Luka-Zagar/crash-detection/[02] PROBE 3D MODEL/[04] FULL ASSEMBLY v11.step

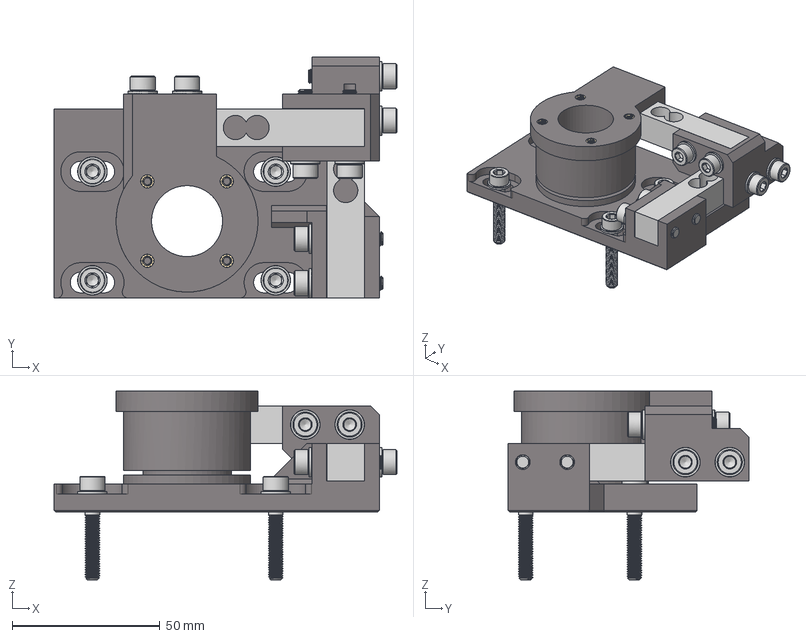
[picture p4: CAD file, 2026-10-09]
[02] PROBE 3D MODEL/[04] FULL ASSEMBLY v11.step
116.0 x 81.5 x 63.9 mm
DAVI - BASE PLATE
LOAD CELL x 2
91166A545_Zinc-Plated Steel General Purpose Washer x 12
91292A192_18-8 Stainless Steel Socket Head Screw x 4
95263A402_Alloy Steel Socket Head Screw x 8
94459A140_Heat-Set Inserts for Plastic x 4
LOAD CELL - BASE PLATE
LASER - BASE TUBE
