Luka-Zagar/crash-detection/[03] CASE 3D MODEL/[04] FULL ASSEMBLY v7.step

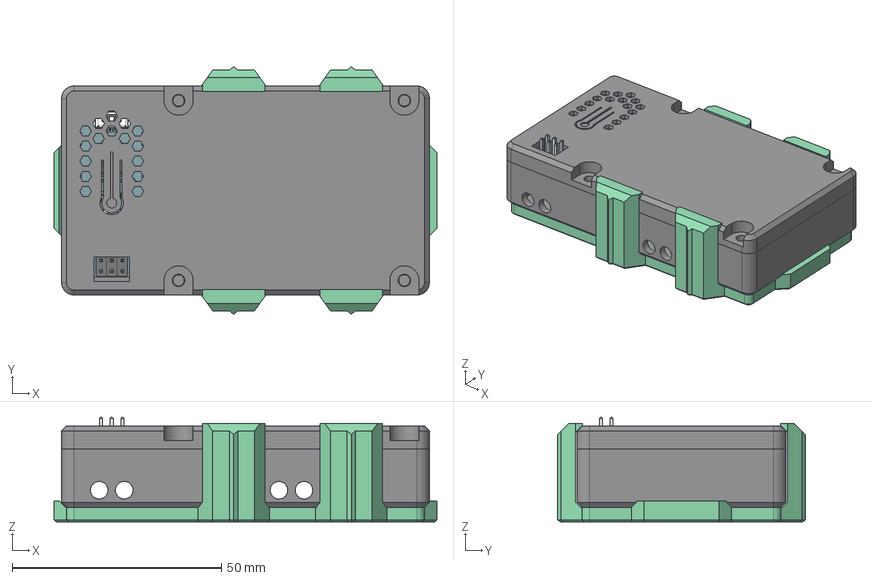
[picture p5: CAD file, 2026-10-09]
[03] CASE 3D MODEL/[04] FULL ASSEMBLY v7.step
91.6 x 59.2 x 25.1 mm
ADS1256 ENCLOSURE BOTTOM
ADS1256 ENCLOSURE TOP
Arduino Nano R3 modified
CLIP PLATE
