Luka-Zagar/crash-detection/[02] PROBE 3D MODEL/[01] DAVI BASE PLATE.step

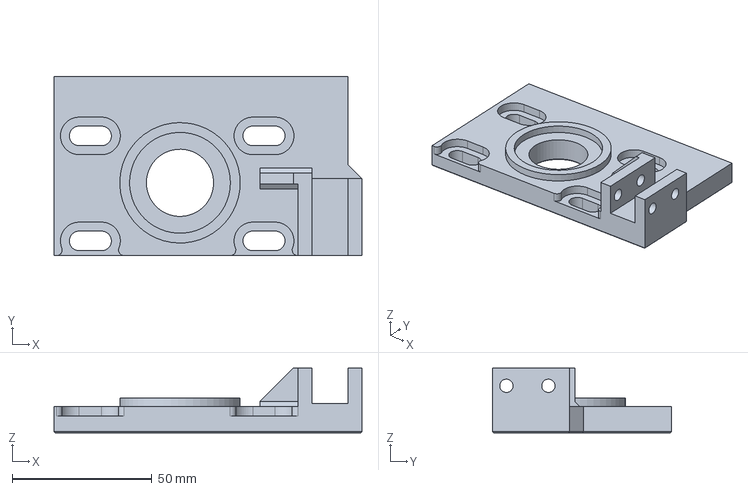
[picture p6: CAD file, 2026-10-09]
[02] PROBE 3D MODEL/[01] DAVI BASE PLATE.step
110.0 x 64.0 x 23.2 mm
