Luka-Zagar/crash-detection/[03] CASE 3D MODEL/[03] CLIP PLATE.step

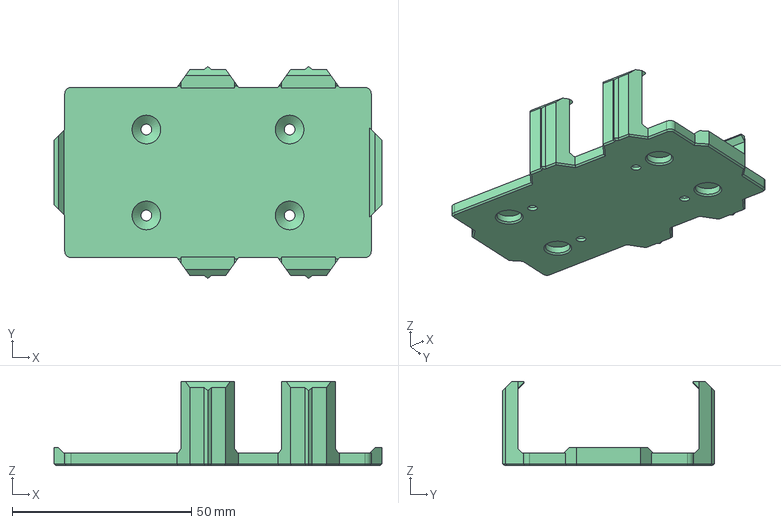
[picture p7: CAD file, 2026-10-09]
[03] CASE 3D MODEL/[03] CLIP PLATE.step
91.6 x 59.2 x 23.5 mm
