Luka-Zagar/crash-detection/[04] 3D PRINTED FILES/CASE PRINTED FILES.3mf

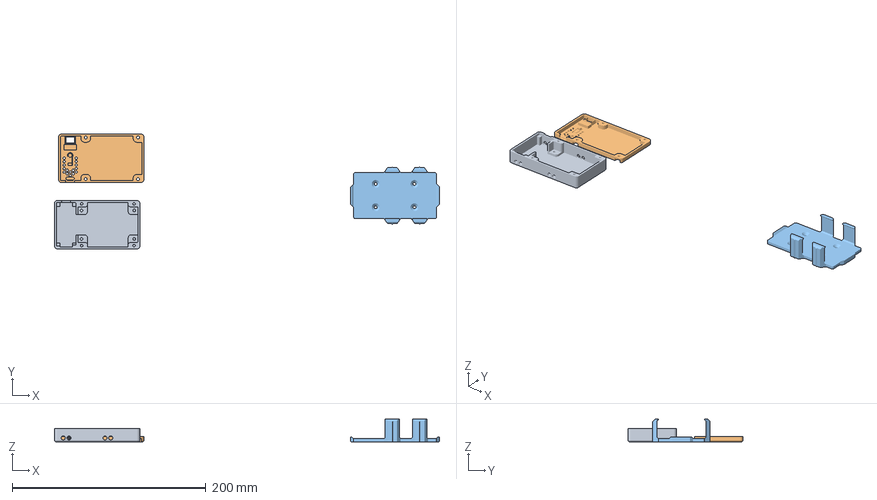
[picture p8: CAD file, 2026-10-09]
[04] 3D PRINTED FILES/CASE PRINTED FILES.3mf
397.0 x 118.5 x 23.5 mm
ADS1256 ENCLOSURE BOTTOM
ADS1256 ENCLOSURE TOP
CLIP PLATE
