Luka-Zagar/crash-detection/[02] PROBE 3D MODEL/[03] LASER BASE TUBE.step

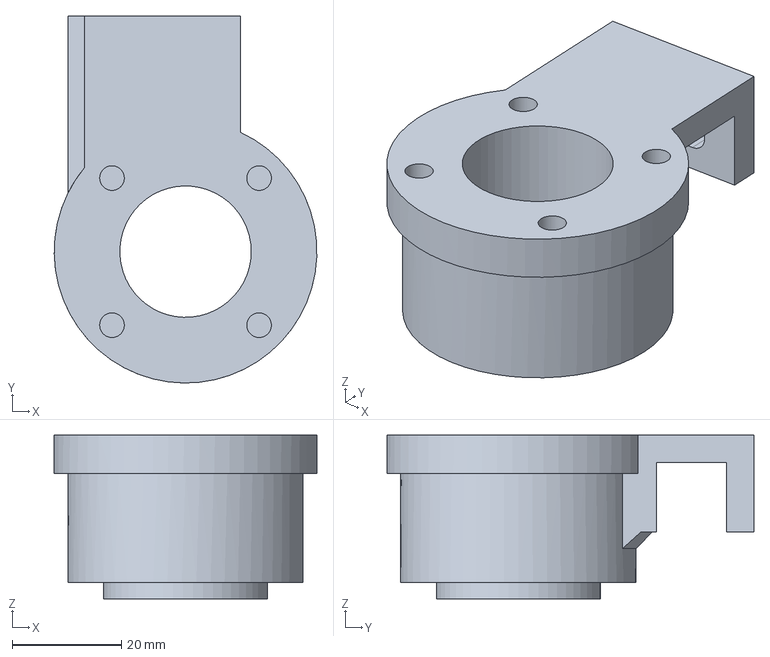
[picture p9: CAD file, 2026-10-09]
[02] PROBE 3D MODEL/[03] LASER BASE TUBE.step
48.0 x 67.0 x 29.9 mm
