Luka-Zagar/crash-detection/[03] CASE 3D MODEL/[01] ADS1256 ENCLOSURE BOTTOM.step

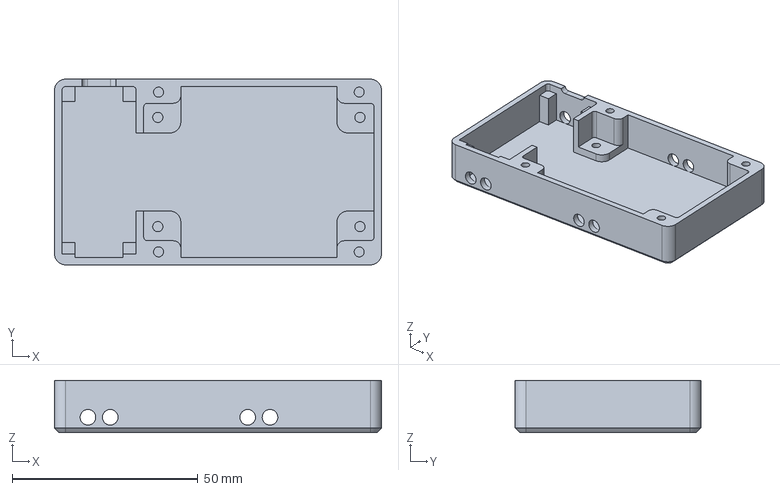
[picture p10: CAD file, 2026-10-09]
[03] CASE 3D MODEL/[01] ADS1256 ENCLOSURE BOTTOM.step
88.0 x 50.0 x 14.0 mm
