Luka-Zagar/crash-detection/[02] PROBE 3D MODEL/[02] LOAD CELL BASE PLATE.step

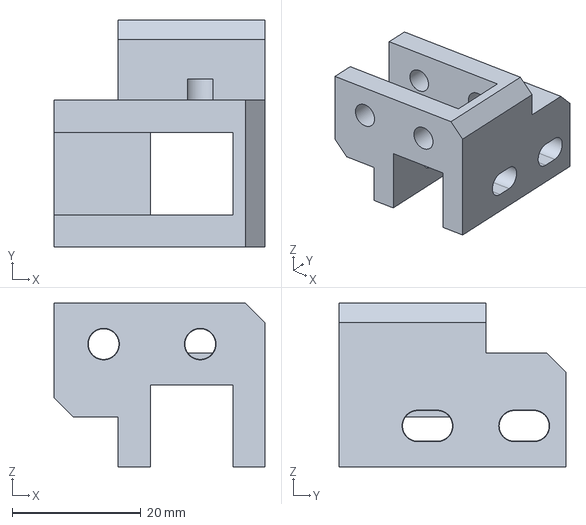
[picture p11: CAD file, 2026-10-09]
[02] PROBE 3D MODEL/[02] LOAD CELL BASE PLATE.step
32.8 x 35.2 x 25.4 mm
