Luka-Zagar/crash-detection/[03] CASE 3D MODEL/[02] ADS1256 ENCLOSURE TOP.step

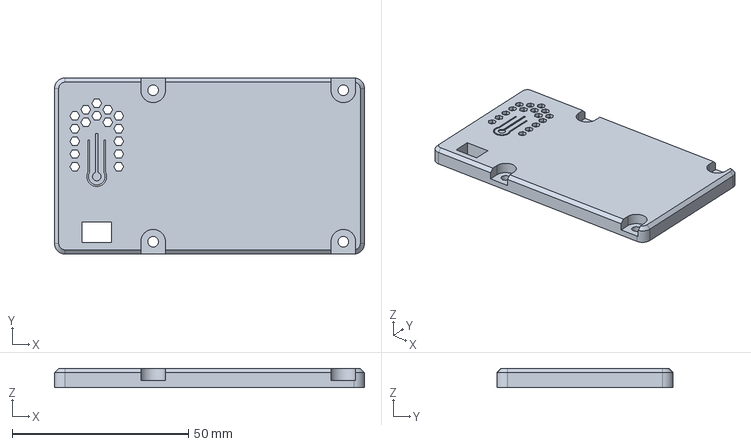
[picture p12: CAD file, 2026-10-09]
[03] CASE 3D MODEL/[02] ADS1256 ENCLOSURE TOP.step
88.0 x 50.0 x 5.50 mm
