Luka-Zagar/crash-detection/[05] PICTURES/Measurement probe render.png

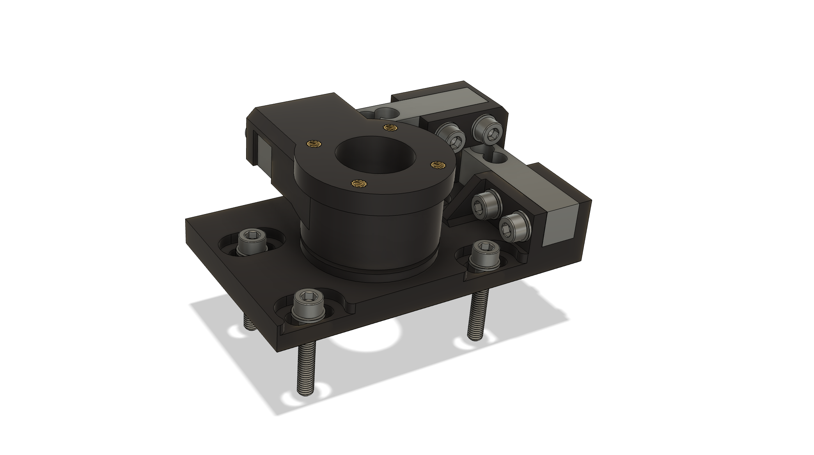
[05] PICTURES/Measurement probe render.png
