Luka-Zagar/crash-detection/(commit log)

2026-10-09 Crash detection for DAVI M300 laser head on ABB robot
    [CASE PRINTED FILES.3mf, [01] ADS1256 ENCLOSURE BOTTOM.step, [01] DAVI BASE PLATE.step, [02] ADS1256 ENCLOSURE TOP.step, [02] LOAD CELL BASE PLATE.step, [03] CLIP PLATE.step, [03] LASER BASE TUBE.step, [04] FULL ASSEMBLY v11.step]
2026-10-09 Renaming to Measurement probe.jpg
2026-10-09 Renaming to Measurement probe render.png
